SoraMause/NovemAlter/NovemAlter/electronic/novemkai.pdf

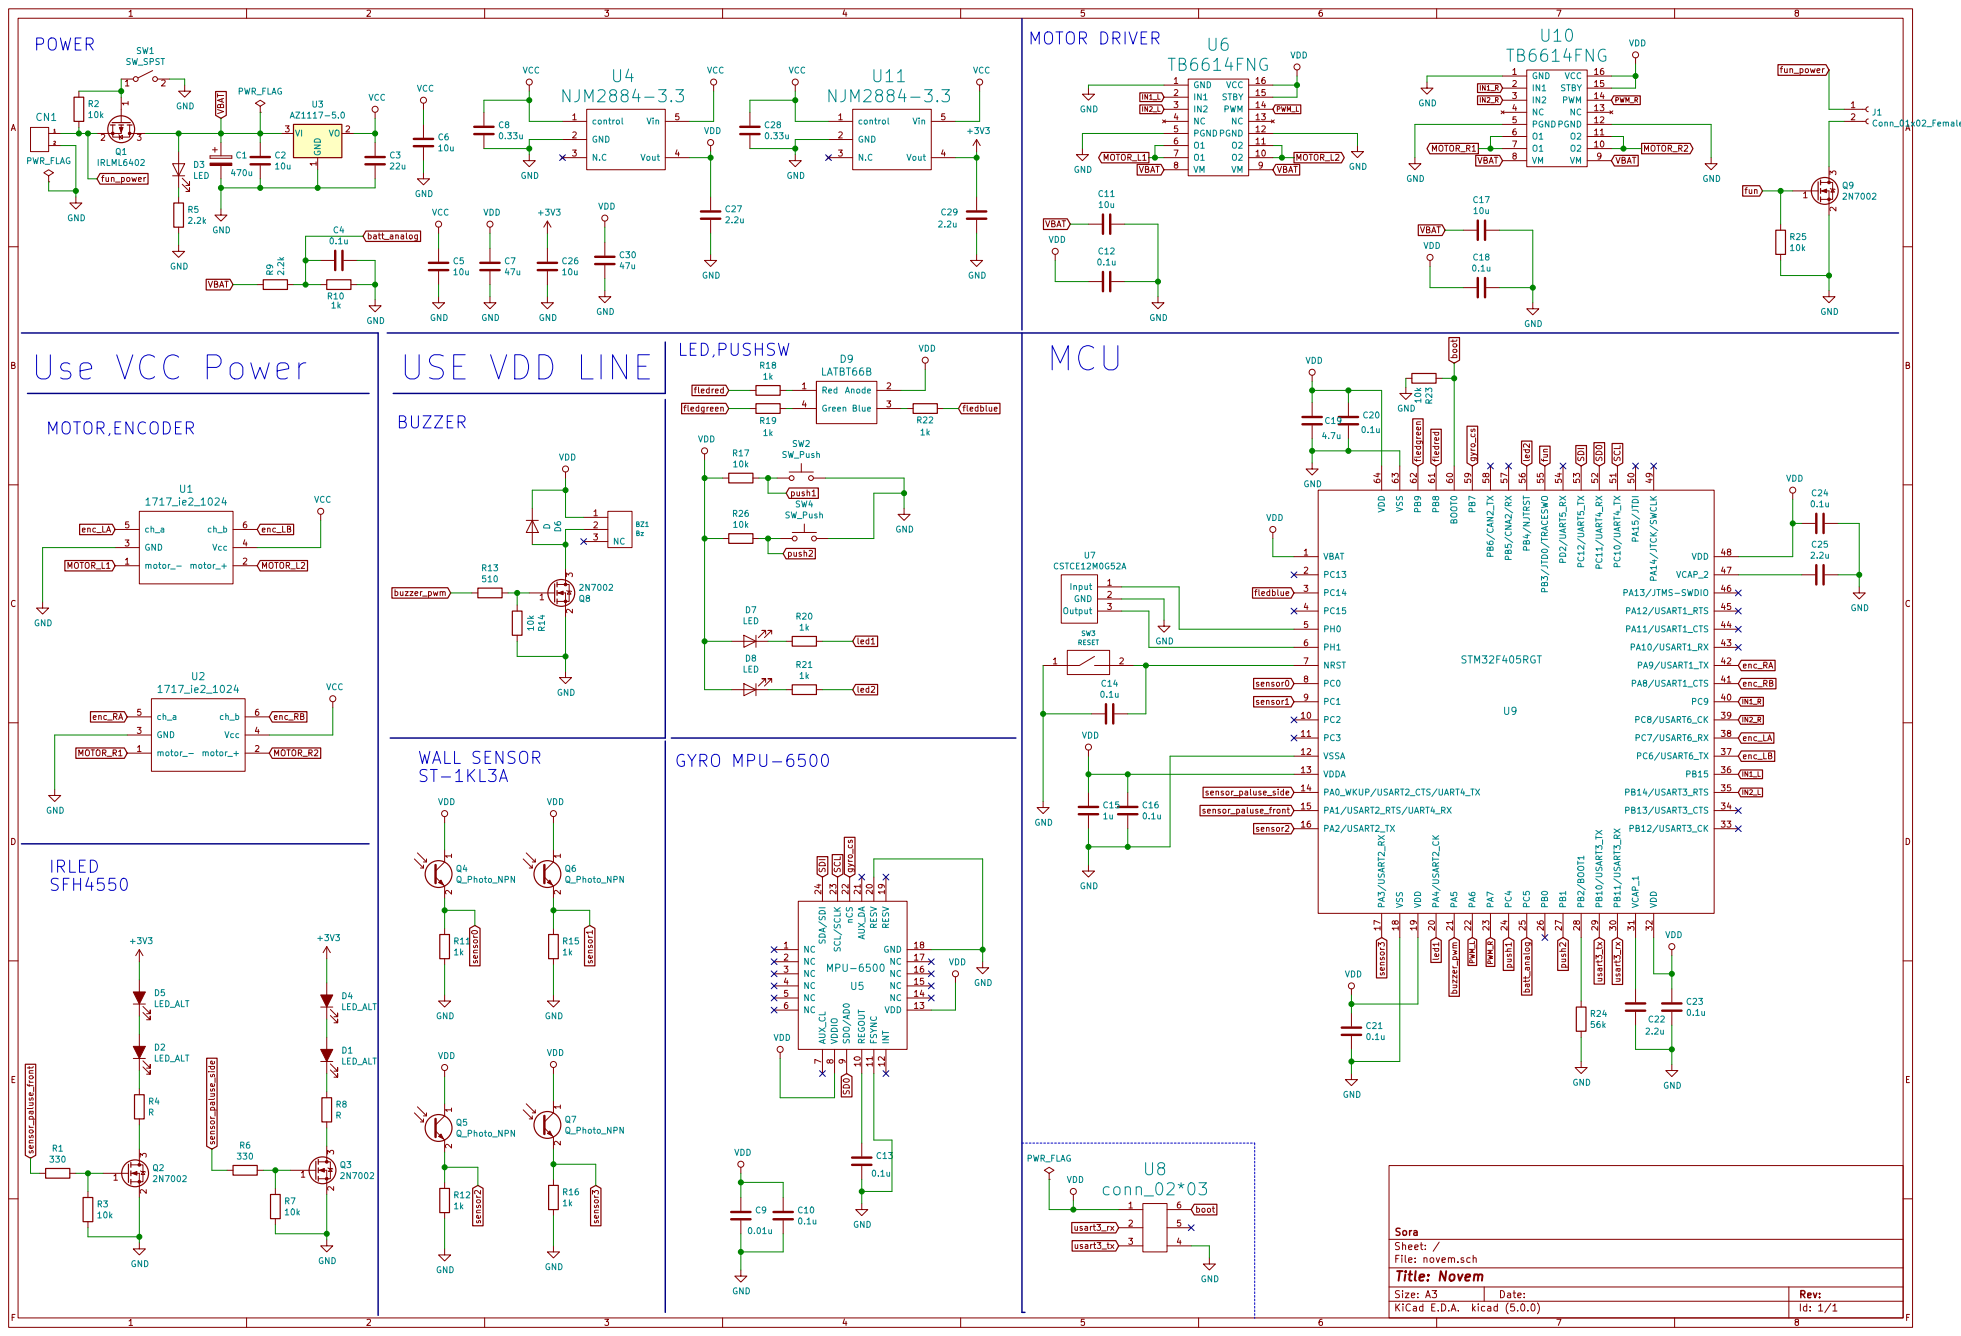
[picture p1: page 1]

POWER
VCC GND Use VCC Power

File: novem.sch Sheet: / Sora GND
