SoraMause/NovemAlter/NovemAlter/program/Src/main.c

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

/* Includes ------------------------------------------------------------------*/
#include "main.h"
#include "adc.h"
#include "dma.h"
#include "spi.h"
#include "tim.h"
#include "usart.h"
#include "gpio.h"

/* USER CODE BEGIN Includes */
#include <stdio.h>
#include <stdint.h>

#include "variable.h"
#include "function.h"
#include "led.h"
#include "buzzer.h"

#include "run.h"

#include "mode.h"

#ifdef __GNUC__
#define PUTCHAR_PROTOTYPE int __io_putchar(int ch)
#else
#define PUTCHAR_PROTOTYPE int fputc(int ch, FILE *f)
#endif /* __GNUC__ */
void __io_putchar(uint8_t ch) {
HAL_UART_Transmit(&huart3, &ch, 1, 1);
}
/* USER CODE END Includes */


/* USER CODE BEGIN PV */

/* USER CODE END PV */

void SystemClock_Config(void);
/* USER CODE BEGIN PFP */

/* USER CODE END PFP */

/**
  * @brief  The application entry point.
  * @retval int
  */
int main(void)
{
  /* MCU Configuration--------------------------------------------------------*/

  /* Reset of all peripherals, Initializes the Flash interface and the Systick. */
  HAL_Init();

  /* Configure the system clock */
  SystemClock_Config();

  /* Initialize all configured peripherals */
  MX_GPIO_Init();
  MX_DMA_Init();
  MX_ADC1_Init();
  MX_ADC2_Init();
  MX_USART3_UART_Init();
  MX_SPI3_Init();
  MX_TIM8_Init();
  MX_TIM1_Init();
  MX_TIM3_Init();
  MX_TIM2_Init();
  /* USER CODE BEGIN 2 */
  machine_init();
  //setIrledPwm( IRLED_ON );
  /* USER CODE END 2 */

  /* Infinite loop */
  /* USER CODE BEGIN WHILE */
  while (1)
  {
    /* USER CODE END WHILE */

    /* USER CODE BEGIN 3 */
    printf( "gyro z%f, batt_voltage : %f\r",rotation_real.velocity, batt_monitor );

    if( mode_counter == 0 ){
      certainLedOut( LED_OFF );
      fullColorLedOut( LED_OFF );
    } else if ( mode_counter == 8 ){
      certainLedOut( LED_BOTH );
      fullColorLedOut( LED_OFF );
    } else {
      certainLedOut( LED_OFF );
      fullColorLedOut( mode_counter );
    }

    if ( mode_distance > 30.0f ){
      mode_counter++;
      mode_distance = 0.0f;
      if ( mode_counter > 8 ) mode_counter = 0;
      buzzermodeSelect( mode_counter );
      waitMotion( 300 );
    }

    if ( mode_distance < -30.0f ){
      mode_counter--;
      mode_distance = 0.0f;
      if ( mode_counter < 0 ) mode_counter = 8;
      buzzermodeSelect( mode_counter );
      waitMotion( 300 );
    }

    if ( getPushsw() ){
      modeSelect( mode_counter );
    }

    if ( batt_monitor < 7.0f ){
      while( 1 ){
        certainLedOut( 0x0f );
        fullColorLedOut( LED_RED );
        waitMotion( 1000 );
        certainLedOut( LED_OFF );
        fullColorLedOut( LED_OFF );
        waitMotion( 1000 );
      }
    }
  }
  /* USER CODE END 3 */
}

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
