SoraMause/NovemAlter/NovemAlter/electronic/novem.ioc

Mcu.UserName=STM32F405RGTx
PA0-WKUP.GPIO_Label=sensor_paluseSide
PA0-WKUP.Signal=GPIO_Output
PA1.GPIO_Label=sensor_paluseFront
PA1.Signal=GPIO_Output
PA2.Signal=ADCx_IN2
PA3.Signal=ADCx_IN3
PA4.GPIO_Label=led1
PA4.Signal=GPIO_Output
PA5.Signal=S_TIM2_CH1_ETR
PA6.Signal=S_TIM3_CH1
PA7.Signal=S_TIM3_CH2
PA8.Signal=S_TIM1_CH1
PA9.Signal=S_TIM1_CH2
PB1.GPIO_Label=push_sw2
PB1.Signal=GPIO_Input
PB10.Signal=USART3_TX
PB11.Signal=USART3_RX
PB14.GPIO_Label=IN2_L
PB14.Signal=GPIO_Output
PB15.GPIO_Label=IN1_L
PB15.Signal=GPIO_Output
PB3.Signal=S_TIM2_CH2
PB4.GPIO_Label=led2
PB4.Signal=GPIO_Output
PB7.GPIO_Label=gyro_cs
PB7.Signal=GPIO_Output
PB8.GPIO_Label=fledred
PB8.Signal=GPIO_Output
PB9.GPIO_Label=fledgreen
PB9.Signal=GPIO_Output
PC0.Signal=ADCx_IN10
PC1.Signal=ADCx_IN11
PC10.Signal=SPI3_SCK
PC11.Signal=SPI3_MISO
PC12.Signal=SPI3_MOSI
PC14-OSC32_IN.GPIO_Label=fled_blue
PC14-OSC32_IN.Signal=GPIO_Output
PC4.GPIO_Label=pushsw1
PC4.Signal=GPIO_Input
PC5.Signal=ADCx_IN15
PC6.Signal=S_TIM8_CH1
PC7.Signal=S_TIM8_CH2
PC8.GPIO_Label=IN2_R
PC8.Signal=GPIO_Output
PC9.GPIO_Label=IN1_R
PC9.Signal=GPIO_Output
PH0-OSC_IN.Signal=RCC_OSC_IN
PH1-OSC_OUT.Signal=RCC_OSC_OUT
