SoraMause/NovemAlter/NovemAlter/program/Src/mode.c

#include "mode.h"

#include "stm32f4xx_hal.h"
#include "spi.h"
#include "tim.h"

#include <stdio.h>

#include "run.h"
#include "motion.h"
#include "targetGenerator.h"

#include "timer.h"

#include "maze.h"
#include "agent.h"

#include "buzzer.h"
#include "led.h"
#include "flash.h"
#include "function.h"
#include "logger.h"

#include "mazeRun.h"

// ゴール座標の設定
static uint8_t goal_x = 7;
static uint8_t goal_y = 7;
static uint8_t maze_goal_size = 1;

void modeSelect( int8_t mode )
{

  mode_init();

  switch( mode ){
    case 0:
      mode0();
      break;

    case 1:
      mode1();
      break;

    case 2:
      mode2();
      break;

    case 3:
      mode3();
      break;
    
    case 4:
      mode4();
      break;

    case 5:
      mode5();
      break;
    
    case 6:
      mode6();
      break;

    case 7:
      mode7();
      break;

    case 8:
      mode8();
      break;

    default:
      break;
  }
  adcEnd();
  HAL_Delay( 300 );
  translation_ideal.accel = 0.0;
	translation_ideal.velocity = 0.0;
  setControlFlag( 0 );
  mode_counter = 0;
  mode_distance = 0.0f;
}

void mode_init( void )
{
  printf("\r\n");
  failSafe_flag = 0;
  mode_distance = 0.0f;
  mode_counter |= 0x80;
	translation_ideal.accel = 0.0;
	translation_ideal.velocity = 0.0;
	translation_ideal.distance = 0.0;
	rotation_ideal.accel = 0.0;
	rotation_ideal.distance = 0.0;
	rotation_ideal.velocity = 0.0;
	rotation_trape_param.back_rightturn_flag = 0;
	rotation_deviation.cumulative = 0.0;
  // to do search param と fast paramで分けれるようにする
  setSlaromOffset( &slarom500, 18.5f, 19.5f, 18.5f, 19.5f, 7200.0f, 600.0f );

  setPIDGain( &translation_gain, 1.5f, 35.0f, 0.0f );  
  setPIDGain( &rotation_gain, 0.47f, 45.0f, 0.0f ); 
  setPIDGain( &sensor_gain, 0.2f, 0.0f, 0.0f );

  setSenDiffValue( 7 );

  // sensor 値設定
  setSensorConstant( &sen_front, 650, 140 );
  // 区画中心　前壁 195
  //setSensorConstant( &sen_l, 390, 155 );
  //setSensorConstant( &sen_r, 275, 135 );
  setSensorConstant( &sen_l, 390, 175 );
  setSensorConstant( &sen_r, 275, 155 );

  certainLedOut( LED_LEFT );
  waitMotion( 100 );
  certainLedOut( LED_OFF );
  waitMotion( 100 );
  certainLedOut( LED_LEFT );
  waitMotion( 100 );
  certainLedOut( LED_OFF );
  fullColorLedOut( LED_OFF );
  waitMotion( 100 );
}

void startAction( void )
{
  while( getPushsw() == 0 );
  log_init();
  buzzerSetMonophonic( A_SCALE, 200 );
  HAL_Delay( 300 );
  fullColorLedOut( LED_MAGENTA );
  adcStart();
  while( sen_front.now < 600 );
  fullColorLedOut( LED_YELLOW );
  buzzerSetMonophonic( C_H_SCALE, 300 );
  adcEnd();
  waitMotion( 500 );
  MPU6500_z_axis_offset_calc_start();
  while( MPU6500_calc_check() ==  0 );
  fullColorLedOut( LED_OFF );
  adcStart();
  waitMotion( 100 );
  setLogFlag( 1 );
  setControlFlag( 1 );
}

void writeFlashData( t_walldata *wall )
{
  certainLedOut( LED_OFF );
  fullColorLedOut( 0x04 );
  wall->save = 1;

  for ( int i = 0; i <= MAZE_HALF_MAX_SIZE; i++ ){
    wall->column_known[i] = 0xffffffff;
    wall->row_known[i] = 0xffffffff;
  }

  writeFlash( start_address, (uint8_t*)wall, sizeof( t_walldata ) );
}

void loadWallData( t_walldata *wall )
{
  loadFlash( start_address, (uint8_t *)wall, sizeof( t_walldata ) );
}

// 足立法探索
void mode0( void )
{
  setNormalRunParam( &run_param, 4000.0f, 500.0f );       // 加速度、探索速度指定
  setNormalRunParam( &rotation_param, 5400.0f, 450.0f );  // 角加速度、角速度指定
  wall_Init( &wall_data, MAZE_CLASSIC_SIZE );
  wallBIt_Init( &wall_bit, MAZE_CLASSIC_SIZE );
  setMazeGoalSize( maze_goal_size );
  positionReset( &mypos );

  startAction();

  adachiSearchRun( goal_x, goal_y, &run_param, &rotation_param, &wall_data, &wall_bit, &mypos, MAZE_CLASSIC_SIZE );
  adcEnd();
  setControlFlag( 0 );
  writeFlashData( &wall_bit );
  adcStart();
  setControlFlag( 1 );
  adachiSearchRun( 0, 0, &run_param, &rotation_param, &wall_data, &wall_bit, &mypos, MAZE_CLASSIC_SIZE );
  adcEnd();
  setControlFlag( 0 );
  writeFlashData( &wall_bit );
  
}

// 足立法最短(斜めなし)
void mode1( void )
{
  setNormalRunParam( &run_param, 8000.0f, 500.0f );       // 加速度、速度指定
  setNormalRunParam( &rotation_param, 6300.0f, 540.0f );  // 角加速度、角速度指定

  loadWallData( &wall_data );
  agentSetShortRoute( goal_x, goal_y, &wall_data, MAZE_CLASSIC_SIZE, 0, 0 );
  
  positionReset( &mypos );
  startAction();

  adachiFastRun( &run_param, &rotation_param );

  setControlFlag( 0 );
}

// 足立法最短( 斜めあり )
void mode2( void )
{

  int8_t speed_count = 0;
  int8_t _straight = 0;

  loadWallData( &wall_data );
  positionReset( &mypos );

  while( getPushsw() == 0 ){
    printf( "mode_distance = %5.5f, speed_count = %1d\r",mode_distance, speed_count );
    if ( mode_distance > 30.0f ){
      speed_count++;
      mode_distance = 0.0f;
      if ( speed_count > 7 ) speed_count = 0;
      buzzermodeSelect( speed_count );
      waitMotion( 300 );
    }

    if ( mode_distance < -30.0f ){
      speed_count--;
      mode_distance = 0.0f;
      if ( speed_count < 0 ) speed_count = 7;
      buzzermodeSelect( speed_count );
      waitMotion( 300 );
    }

    fullColorLedOut( speed_count );
  }

  certainLedOut( LED_BOTH );
  waitMotion( 100 );
  certainLedOut( LED_OFF );

  if ( speed_count == 0 ){
    speed_count = PARAM_1000;
    setNormalRunParam( &run_param, 8000.0f, 1000.0f );       // 加速度、速度指定
    setNormalRunParam( &rotation_param, 6300.0f, 450.0f );  // 角加速度、角速度指定  
    setPIDGain( &translation_gain, 2.0f, 40.0f, 0.0f );
    setSenDiffValue( 15 );
  } else if ( speed_count == 1 ){
    speed_count = PARAM_1400;
    setNormalRunParam( &run_param, 18000.0f, 1000.0f );       // 加速度、速度指定
    setNormalRunParam( &rotation_param, 6300.0f, 450.0f );  // 角加速度、角速度指定  
    setPIDGain( &translation_gain, 2.6f, 45.0f, 0.0f );  
    setPIDGain( &rotation_gain, 0.55f, 60.0f, 0.0f );
    setSenDiffValue( 35 ); 
  } else if ( speed_count == 2 ){
    speed_count = PARAM_1400;
    setNormalRunParam( &run_param, 18000.0f, 1000.0f );       // 加速度、速度指定
    setNormalRunParam( &rotation_param, 6300.0f, 450.0f );  // 角加速度、角速度指定  
    setPIDGain( &translation_gain, 2.6f, 45.0f, 0.0f );  
    setPIDGain( &rotation_gain, 0.55f, 60.0f, 0.0f );
    setSenDiffValue( 35 ); 
    _straight = 1;
  } else if ( speed_count == 3 ){
    speed_count = PARAM_1600;
    setNormalRunParam( &run_param, 20000.0f, 1000.0f );       // 加速度、速度指定
    setNormalRunParam( &rotation_param, 6300.0f, 450.0f );  // 角加速度、角速度指定  
    setPIDGain( &translation_gain, 2.6f, 45.0f, 0.0f );  
    setPIDGain( &rotation_gain, 0.56f, 60.0f, 0.0f );
    setSenDiffValue( 45 ); 
  } else if ( speed_count == 4 ){
    speed_count = PARAM_1600;
    setNormalRunParam( &run_param, 20000.0f, 1000.0f );       // 加速度、速度指定
    setNormalRunParam( &rotation_param, 6300.0f, 450.0f );  // 角加速度、角速度指定  
    setPIDGain( &translation_gain, 2.6f, 45.0f, 0.0f );  
    setPIDGain( &rotation_gain, 0.56f, 60.0f, 0.0f );
    setSenDiffValue( 45 ); 
    _straight = 1;
  } else if ( speed_count == 5 ){
    speed_count = PARAM_1700;
    setNormalRunParam( &run_param, 22000.0f, 1000.0f );       // 加速度、速度指定
    setNormalRunParam( &rotation_param, 6300.0f, 450.0f );  // 角加速度、角速度指定  
    setPIDGain( &translation_gain, 2.6f, 45.0f, 0.0f );  
    setPIDGain( &rotation_gain, 0.57f, 60.0f, 0.0f );
    setSenDiffValue( 150 ); 
  } else if ( speed_count == 6 ){
    speed_count = PARAM_1700;
    setNormalRunParam( &run_param, 22000.0f, 1000.0f );       // 加速度、速度指定
    setNormalRunParam( &rotation_param, 6300.0f, 450.0f );  // 角加速度、角速度指定  
    setPIDGain( &translation_gain, 2.6f, 45.0f, 0.0f );  
    setPIDGain( &rotation_gain, 0.57f, 60.0f, 0.0f );
    setSenDiffValue( 150 ); 
    _straight = 1;
  } else if ( speed_count == 7 ){
    speed_count = MAX_PARAM;
    setNormalRunParam( &run_param, 22000.0f, 1000.0f );       // 加速度、速度指定
    setNormalRunParam( &rotation_param, 6300.0f, 450.0f );  // 角加速度、角速度指定  
    setPIDGain( &translation_gain, 2.6f, 45.0f, 0.0f );  
    setPIDGain( &rotation_gain, 0.60f, 60.0f, 0.0f );
    setSenDiffValue( 180 ); 
    _straight = 1;
  } 
  
  
  if ( agentDijkstraRoute( goal_x, goal_y, &wall_data, MAZE_CLASSIC_SIZE, _straight, speed_count, 0 ) == 0 ){
    return;
  }

  startAction();

  if ( speed_count == PARAM_1000 ){
    adachiFastRunDiagonal1000( &run_param, &rotation_param );
  } else if ( speed_count == PARAM_1400 ) {
    adachiFastRunDiagonal1400( &run_param, &rotation_param );
  } else if ( speed_count == PARAM_1600 ){
    adachiFastRunDiagonal1600( &run_param, &rotation_param );
  } else if ( speed_count == PARAM_1700 ){
    adachiFastRunDiagonal1700( &run_param, &rotation_param );
  } else if ( speed_count == MAX_PARAM ){
    adachiFastRunDiagonalMax( &run_param, &rotation_param );
  } 

  // debug 
  fullColorLedOut( 0x0f );
  certainLedOut( 0x00 );
  waitMotion( 2000 );
  fullColorLedOut( 0x00 );
  while( getPushsw() == 0 ){
    printf( "log_wait\r");
  }
  showLog();  

}

// 各種センサー値確認,最短パスチェック
void mode3( void )
{
  loadWallData( &wall_data );
  HAL_Delay( 300 );
  adcStart();
  cnt_motion = 0;
  while( 1 ){
    printf( "fl : %4d, l: %4d, r: %4d, fr: %4d, front : %4d\r",sen_fl.now, sen_l.now, sen_r.now, sen_fr.now, sen_front.now );
    if ( getPushsw() == 1 && cnt_motion >= 2000 ) break;
  }
  adcEnd();
  if ( wall_data.save == 1 ){
    //agentSetShortRoute( goal_x, goal_y, &wall_data, MAZE_CLASSIC_SIZE, 1, 0 );
    agentDijkstraRoute( goal_x, goal_y, &wall_data, MAZE_CLASSIC_SIZE, 0, MAX_PARAM, 1 );
  }
  
}

// knwon search
void mode4( void )
{
  setNormalRunParam( &run_param, 4000.0f, 500.0f );       // 加速度、探索速度指定
  setNormalRunParam( &rotation_param, 5400.0f, 450.0f );  // 角加速度、角速度指定
  wall_Init( &wall_data, MAZE_CLASSIC_SIZE );
  wallBIt_Init( &wall_bit, MAZE_CLASSIC_SIZE );
  setMazeGoalSize( maze_goal_size );
  positionReset( &mypos );

  startAction();

  adachiSearchRunKnown( goal_x, goal_y, &run_param, &rotation_param, &wall_data, &wall_bit, &mypos, MAZE_CLASSIC_SIZE );
  adcEnd();
  setControlFlag( 0 );
  writeFlashData( &wall_bit );
  setVirtualGoal( MAZE_CLASSIC_SIZE, &wall_data );

  mazeUpdateMap( 0, 0, &wall_data, MAZE_CLASSIC_SIZE );

  if ( checkAllSearch() == 1 ){
    fullColorLedOut( 0x0f );
    waitMotion( 100 );
    fullColorLedOut( LED_OFF );
  } else {
    adcStart();
    setControlFlag( 1 );
    adachiSearchRunKnown( 0, 0, &run_param, &rotation_param, &wall_data, &wall_bit, &mypos, MAZE_CLASSIC_SIZE );
    adcEnd();
    setControlFlag( 0 );
    writeFlashData( &wall_bit );
  }

}

// 重ね探索
void mode5( void )
{


}

// 回転方向のチェック
void mode6( void )
{
  startAction();
  setRotation( 180.0f, 6300.0f, 540.0f, 0.0f );
  waitRotation();
  waitMotion( 300 );
  setRotation( 180.0f, 6300.0f, 540.0f, 0.0f );
  waitRotation();
  setLogFlag( 0 );
  setControlFlag( 0 );
  while( getPushsw() == 0 );
  showLog();
}

// スラロームチェック
void mode7( void )
{
  startAction();
  
  adjFront( 4000, 500.0f );
  //straightOneBlock( 500.0f );
  //straightOneBlock( 500.0f );
  //straightOneBlock( 500.0f );
  straightOneBlock( 500.0f );
  straightHalfBlockStop( 4000.0f, 500.0f );
  setLogFlag( 0 );
  setControlFlag( 0 );
  while( getPushsw() == 0 );
  showLog();
}

// 直進、回転組み合わせチェック 超進地旋回
void mode8( void )
{
  buzzerSetMonophonic( NORMAL, 200 );
  HAL_Delay(300); 
  startAction();
  setControlFlag( 0 );
  funControl( FUN_ON );
  waitMotion( 1000 );
  setControlFlag( 0 );
  translation_ideal.velocity = 0.0f;
  rotation_ideal.velocity = 0.0f;
  while( 1 );
}
