SoraMause/NovemAlter/(commit log)

2019-02-16 initial program
    [novem.kicad_pcb, novem.sch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]
2019-02-24 ひとまず走る
2019-02-25 ターン速度1600mm/s
2019-03-24 電通大プチコン
2019-07-13 マウス合宿 訂正var
